aditelik/plane-controller/BOMs/Plane_Project_Digikey_BOM_V2.xlsx

Index | Part Number | Manufacturer Part Number | Description | Quantity | Unit Price | Extended Price
1 | RSF1JTR470CT-ND | RSF1JTR470 | RES 0.47 OHM 1W 5% AXIAL | 6 | 0.23 | 1.38
2 | YAG3757CT-ND | AC0805JR-07100RL | RES SMD 100 OHM 5% 1/8W 0805 | 10 | 0.041 | 0.41
3 | P200CCT-ND | ERJ-6ENF2000V | RES SMD 200 OHM 1% 1/8W 0805 | 3 | 0.1 | 0.30
4 | 486-3465-ND | 1301.9314 | SWITCH TACTILE SPST-NO 0.05A 12V | 3 | 0.24 | 0.72
5 | 277-1578-ND | 1935174 | TERM BLK 3POS SIDE ENTRY 5MM PCB | 2 | 0.6 | 1.20
6 | TC33X-103ECT-ND | TC33X-2-103E | TRIMMER 10K OHM 0.1W J LEAD TOP | 3 | 0.28 | 0.84
7 | 399-1161-1-ND | C0805C153K5RACTU | CAP CER 0.015UF 50V X7R 0805 | 3 | 0.1 | 0.30
8 | 732-7672-1-ND | 885012207078 | CAP CER 1UF 25V X7R 0805 | 20 | 0.08 | 1.60
9 | 516-2581-1-ND | HCPL-181-00DE | OPTOISO 3.75KV TRANS 4MINIFLAT | 2 | 0.58 | 1.16
10 | IRLB8721PBF-ND | IRLB8721PBF | MOSFET N-CH 30V 62A TO-220AB | 4 | 0.85 | 3.40
11 | 401-2002-1-ND | JS202011SCQN | SWITCH SLIDE DPDT 300MA 6V | 2 | 0.48 | 0.96
 |  |  |  |  | Total Price | 12.27
