aditelik/plane-controller/BOMs/Plane_Project_Kicad_BOM_V2.xlsx

Value | Description | Quantity Needed | Quantity Available | Min Order Quantity | Quantity Ordered
0.47 | Resistor, US symbol | 2 | 0 | 2 | 6
1 | Resistor, US symbol | 1 | 10 | 0
10 | Resistor, US symbol | 10 | 14 | 0
100 | Resistor, US symbol | 7 | 0 | 7 | 10
150 | Resistor, US symbol | 1 | 0 | 1 | 3
300 | Resistor, US symbol | 3 | 6 | 0
800 | Resistor, US symbol | 1 | 2 | 0
1301.9314 | Push button switch, four pins, small | 2 | 1 | 1 | 3
1935174 | 3 WAY SCREW TERMINAL BLOCK 5MM PITCH Phoenix Contact Non-Fused Terminal Block | 1 | 0 | 1 | 2
0.1uF | Unpolarized capacitor | 14 | 26 | 0
100K | Resistor, US symbol | 13 | 23 | 0
10K | Resistor, US symbol | 10 | 21 | 0
10K Pot | Trim-potentiometer, US symbol | 1 | 0 | 1 | 3
15nF | Unpolarized capacitor, small symbol | 1 | 0 | 1 | 3
1K | Resistor, US symbol | 5 | 19 | 0
1N5819 | 30V 1A Schottky Barrier Rectifier Diode, DO-41 | 3 | 13 | 0
1uF | Unpolarized capacitor | 17 | 6 | 11 | 20
22pF | Unpolarized capacitor, small symbol | 2 | 8 | 0
47uF | Polarized capacitor | 4 | 7 | 0
5A Fuse | Fuse | 1 | 2 | 0
9B-16.000MBBK-B | 16 MHz Crystal | 1 | 4 | 0
ATmega328P-PU | 20MHz, 32kB Flash, 2kB SRAM, 1kB EEPROM, DIP-28 | 1 | 2 | 0
BAT54HT1G | 100V 0.3A Small Signal Fast Switching Diode, DO-35 | 2 | 3 | 0
BL01RN1A1D2B | Ferrite bead | 1 | 2 | 0
D6C40 F1 LFS | Push button switch, four pins, green | 1 | 1 | 0
DMN65D8L-7 | 0.21A Id, 60V Vds, N-Channel MOSFET, SOT-23 | 2 | 3 | 0
HCPL-181-00DE | Optoisolator | 1 | 0 | 1 | 2
IRF4905 | -74A Id, -55V Vds, Single P-Channel HEXFET Power MOSFET, 20mOhm Ron, TO-220AB | 1 | 2 | 0
IRLB8721PBF | 62A Id, 30V Vds, N-Channel MOSFET, TO-220 | 6 | 3 | 3 | 4
IRS2004 Socket | Half-Bridge Driver, 200V, 290/600mA, PDIP-8/SOIC-8 | 3 | 5 | 0
LM339 Socket | Quad Differential Comparators, DIP-14/SOIC-14/SSOP-14 | 1 | 2 | 0
LM7805_TO220 | Positive 1A 35V Linear Regulator, Fixed Output 5V, TO-220 | 1 | 2 | 0
LTST-C171GKT | Light emitting diode, Green | 5 | 5 | 0
LTST-C171TBKT | Light emitting diode, Blue | 1 | 2 | 0
MCP601-xP Socket | Single 2.7V to 6.0V Single Supply CMOS Op Amps, DIP-8 | 1 | 1 | 0
SMF10A | Zener diode | 1 | 2 | 0
SMF12A | Zener diode | 1 | 1 | 0
SMF5.0A | Zener diode | 1 | 1 | 0
SW_Slide_DPDT | Slide Switch, dual pole double throw | 1 | 0 | 1 | 2
uA7810 | Positive 1A 35V Linear Regulator, Fixed Output 10V, TO-220/TO-263 | 1 | 1 | 0
