aditelik/plane-controller/BOMs/Plane_Project_Auto_BOM_V2.xlsx

Reference | Value | Description
C1 | 47uF | Polarized capacitor
C10 | 1uF | Unpolarized capacitor
C11 | 1uF | Unpolarized capacitor
C12 | 0.1uF | Unpolarized capacitor
C14 | 1uF | Unpolarized capacitor, small symbol
C15 | 22pF | Unpolarized capacitor, small symbol
C16 | 22pF | Unpolarized capacitor, small symbol
C17 | 0.1uF | Unpolarized capacitor
C18 | 0.1uF | Unpolarized capacitor
C19 | 47uF | Polarized capacitor
C2 | 47uF | Polarized capacitor
C20 | 1uF | Unpolarized capacitor
C21 | 0.1uF | Unpolarized capacitor
C22 | 1uF | Unpolarized capacitor, small symbol
C23 | 0.1uF | Unpolarized capacitor
C24 | 1uF | Unpolarized capacitor, small symbol
C25 | 0.1uF | Unpolarized capacitor, small symbol
C26 | 15nF | Unpolarized capacitor, small symbol
C27 | 0.1uF | Unpolarized capacitor
C28 | 0.1uF | Unpolarized capacitor
C29 | 0.1uF | Unpolarized capacitor
C3 | 1uF | Unpolarized capacitor
C30 | 1uF | Unpolarized capacitor
C31 | 1uF | Unpolarized capacitor
C32 | 1uF | Unpolarized capacitor
C36 | 0.1uF | Unpolarized capacitor, small symbol
C4 | 0.1uF | Unpolarized capacitor, small symbol
C5 | 0.1uF | Unpolarized capacitor
C6 | 0.1uF | Unpolarized capacitor
C7 | 47uF | Polarized capacitor
C8 | 0.1uF | Unpolarized capacitor
C9 | 1uF | Unpolarized capacitor
D1 | LTST-C171GKT | Light emitting diode, Green
D10 | LTST-C171TBKT | Light emitting diode, Blue
D12 | BAT54HT1G | 100V 0.3A Small Signal Fast Switching Diode, DO-35
D13 | BAT54HT1G | 100V 0.3A Small Signal Fast Switching Diode, DO-35
D14 | 1N5819 | 30V 1A Schottky Barrier Rectifier Diode, DO-41
D15 | 1N5819 | 30V 1A Schottky Barrier Rectifier Diode, DO-41
D16 | 1N5819 | 30V 1A Schottky Barrier Rectifier Diode, DO-41
D2 | SMF12A | Zener diode
D4 | LTST-C171GKT | Light emitting diode, Green
D5 | SMF10A | Zener diode
D6 | LTST-C171KRKT | Light emitting diode, Green
D7 | LTST-C171GKT | Light emitting diode, Green
D8 | SMF5.0A | Zener diode
D9 | LTST-C171GKT | Light emitting diode, Green
F1 | 5A Fuse | Fuse
FB1 | BL01RN1A1D2B | Ferrite bead
J4 | 1935174 | 3 WAY SCREW TERMINAL BLOCK 5MM PITCH Phoenix Contact Non-Fused Terminal Block
Q10 | IRLB8721PBF | 62A Id, 30V Vds, N-Channel MOSFET, TO-220
Q11 | IRLB8721PBF | 62A Id, 30V Vds, N-Channel MOSFET, TO-220
Q2 | DMN65D8L-7 | 0.21A Id, 60V Vds, N-Channel MOSFET, SOT-23
Q3 | DMN65D8L-7 | 0.21A Id, 60V Vds, N-Channel MOSFET, SOT-23
Q5 | IRF4905 | -74A Id, -55V Vds, Single P-Channel HEXFET Power MOSFET, 20mOhm Ron, TO-220AB
Q6 | IRLB8721PBF | 62A Id, 30V Vds, N-Channel MOSFET, TO-220
Q7 | IRLB8721PBF | 62A Id, 30V Vds, N-Channel MOSFET, TO-220
Q8 | IRLB8721PBF | 62A Id, 30V Vds, N-Channel MOSFET, TO-220
Q9 | IRLB8721PBF | 62A Id, 30V Vds, N-Channel MOSFET, TO-220
R1 | 1K | Resistor, US symbol
R10 | 10K | Resistor, US symbol
R12 | 100K | Resistor, US symbol
R13 | 10K | Resistor, US symbol
R14 | 150 | Resistor, US symbol
R16 | 1K | Resistor, US symbol
R17 | 1K | Resistor, US symbol
R19 | 100K | Resistor, US symbol
R20 | 100K | Resistor, US symbol
R21 | 1 | Resistor, US symbol
R22 | 100K | Resistor, US symbol
R23 | 0.47 | Resistor, US symbol
R24 | 1K | Resistor, US symbol
R25 | 0.47 | Resistor, US symbol
R26 | 10K | Resistor, US symbol
R27 | 10K | Resistor, US symbol
R28 | 10K | Resistor, US symbol
R29 | 10K | Resistor, US symbol
R3 | 1K | Resistor, US symbol
R30 | 10K | Resistor, US symbol
R31 | 10 | Resistor, US symbol
R32 | 10 | Resistor, US symbol
R33 | 10 | Resistor, US symbol
R34 | 10 | Resistor, US symbol
R35 | 10 | Resistor, US symbol
R36 | 10 | Resistor, US symbol
R37 | 10 | Resistor, US symbol
R38 | 10 | Resistor, US symbol
R39 | 10 | Resistor, US symbol
R4 | 300 | Resistor, US symbol
R40 | 100K | Resistor, US symbol
R41 | 100K | Resistor, US symbol
R42 | 100K | Resistor, US symbol
R43 | 100K | Resistor, US symbol
R44 | 100K | Resistor, US symbol
R45 | 100K | Resistor, US symbol
R46 | 100K | Resistor, US symbol
R47 | 100K | Resistor, US symbol
R48 | 100K | Resistor, US symbol
R49 | 10K | Resistor, US symbol
R5 | 800 | Resistor, US symbol
R50 | 10K | Resistor, US symbol
R51 | 10K | Resistor, US symbol
R52 | 100 | Resistor, US symbol
R6 | 300 | Resistor, US symbol
R7 | 300 | Resistor, US symbol
R8 | 10 | Resistor, US symbol
RV1 | 10K Pot | Trim-potentiometer, US symbol
SW2 | D6C40 F1 LFS | Push button switch, generic, two pins
SW3 | 1301.9314 | Push button switch, generic, two pins
SW4 | 1301.9314 | Push button switch, generic, two pins
SW5 | SW_Push_DPDT | Momentary Switch, dual pole double throw
U1 | ATmega328P-PU | 20MHz, 32kB Flash, 2kB SRAM, 1kB EEPROM, DIP-28
U2 | uA7810 | Positive 1A 35V Linear Regulator, Fixed Output 10V, TO-220/TO-263
U3 | LM7805_TO220 | Positive 1A 35V Linear Regulator, Fixed Output 5V, TO-220
U4 | MCP601-xP | Single 2.7V to 6.0V Single Supply CMOS Op Amps, DIP-8
U5 | LM339 | Quad Differential Comparators, DIP-14/SOIC-14/SSOP-14
U6 | IRS2004 | Half-Bridge Driver, 200V, 290/600mA, PDIP-8/SOIC-8
U7 | IRS2004 | Half-Bridge Driver, 200V, 290/600mA, PDIP-8/SOIC-8
U8 | IRS2004 | Half-Bridge Driver, 200V, 290/600mA, PDIP-8/SOIC-8
U9 | HCPL-181-00DE
Y1 | 9B-16.000MBBK-B | 16 MHz Crystal
