aditelik/plane-controller/KicadFiles/bldc_controller_v2.kicad_pcb

## KiCad design KicadFiles/bldc_controller_v2.kicad_pcb (2020-01-07)

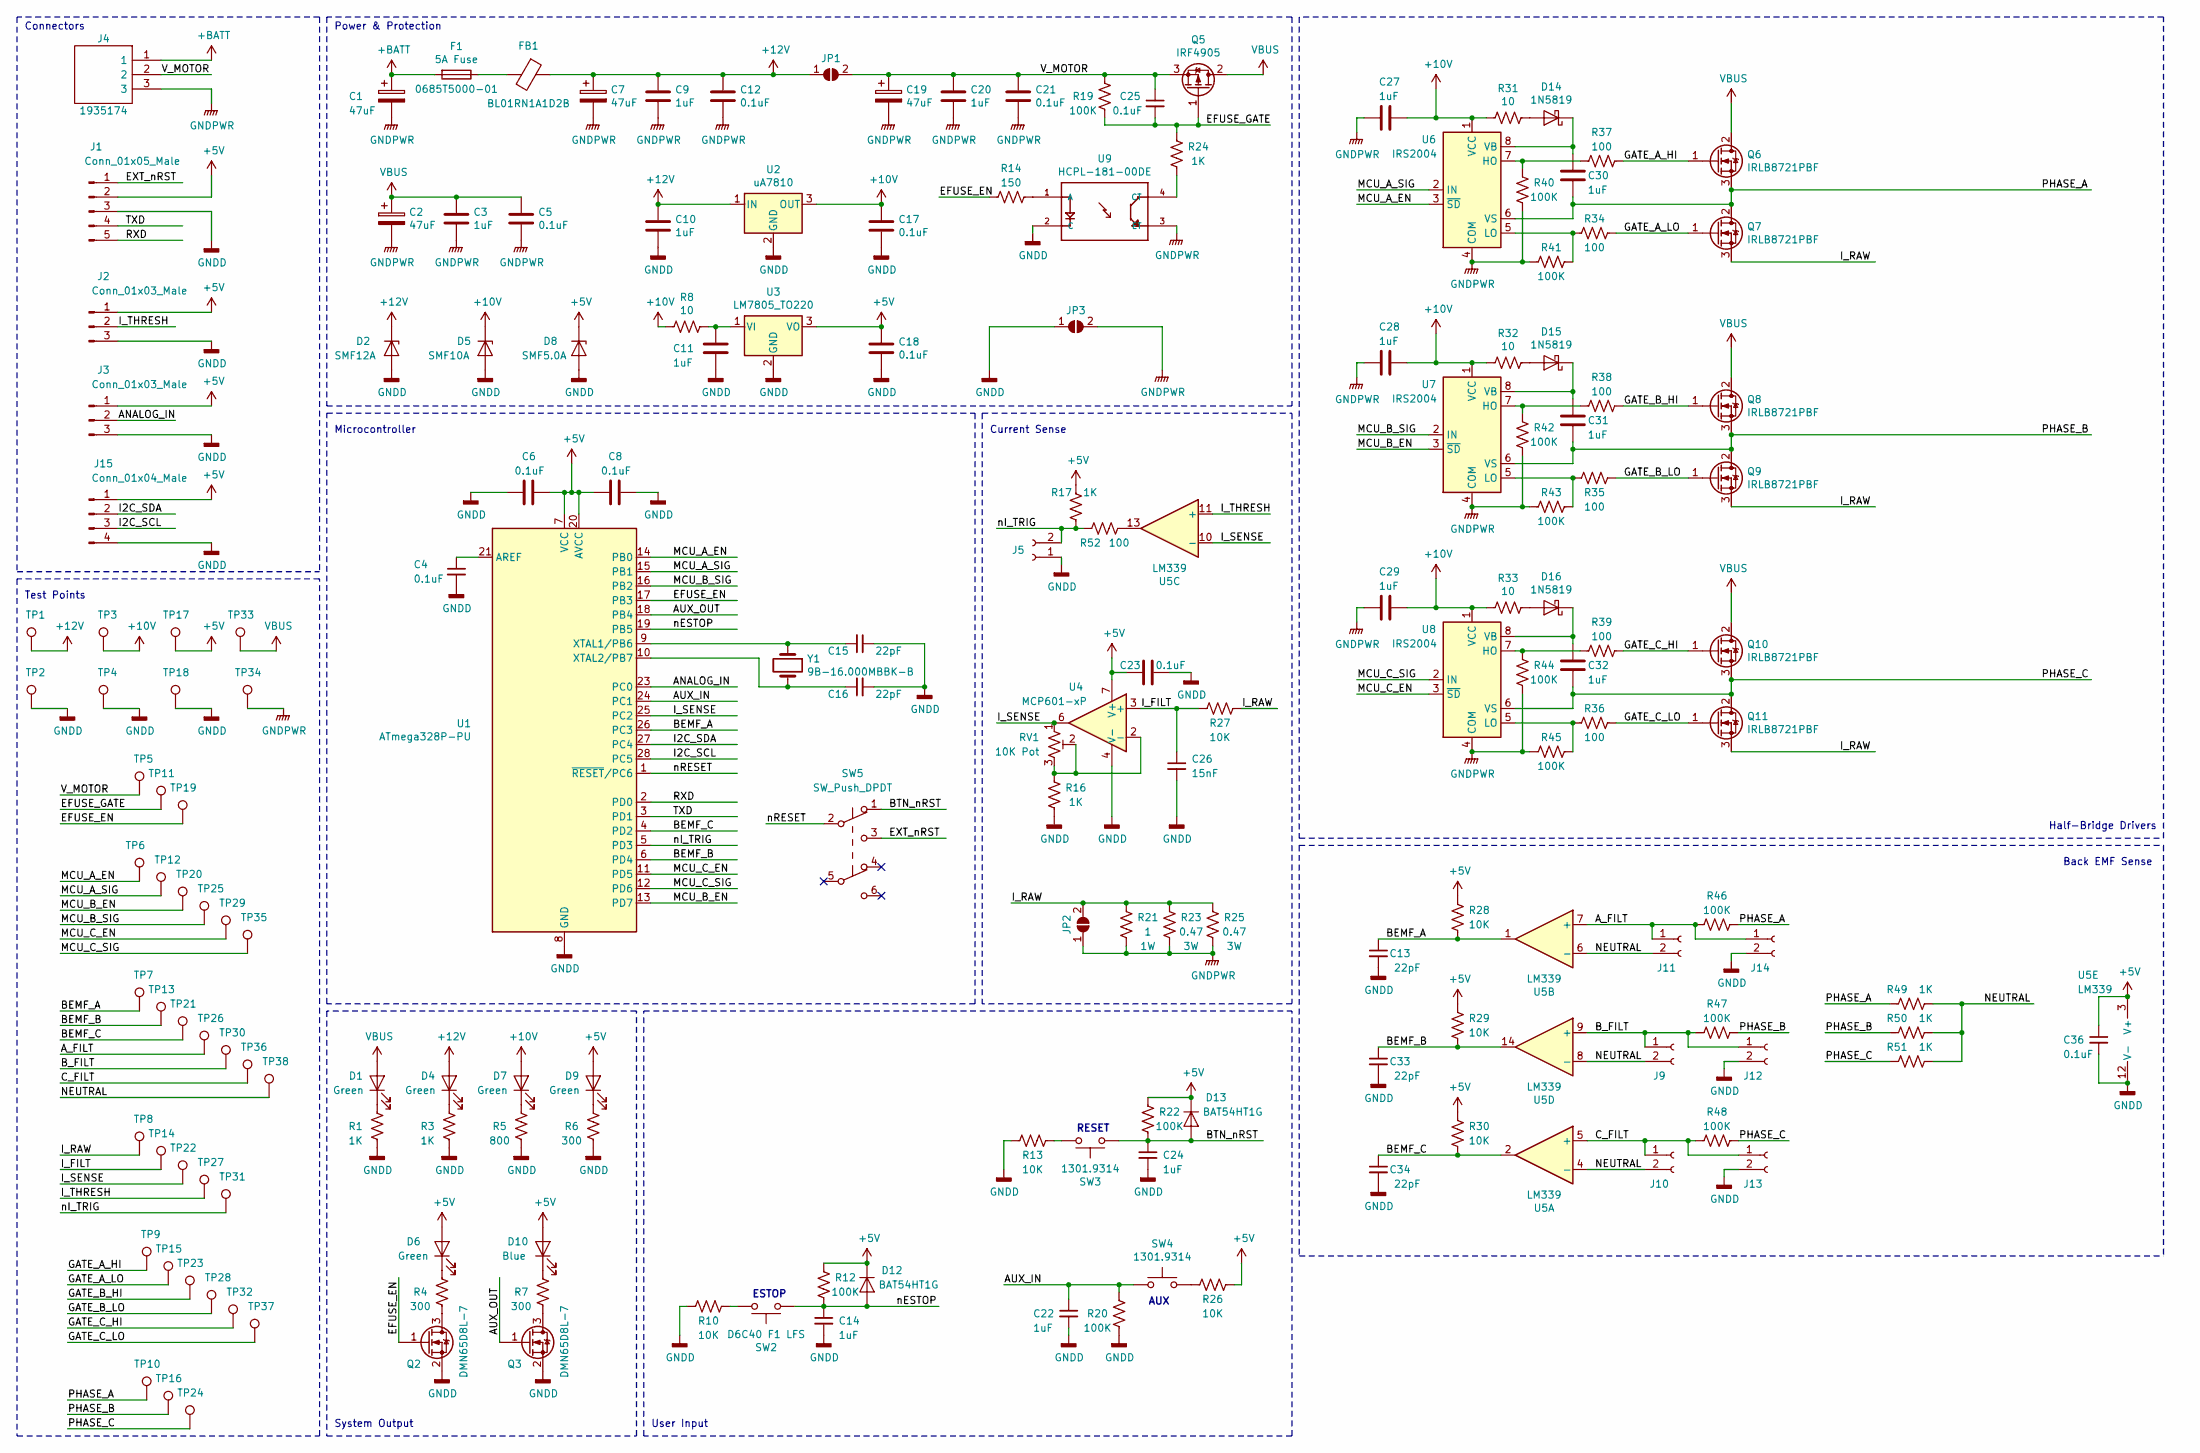
[picture p1: schematic bldc_controller_v2.sch, BLDC Motor Controller]

Parts:
C1, C2, C7, C19: 47uF; CP_Radial_D5.0mm_P2.00mm
C3, C9, C10, C11, C14, C20, C22, C24, C27, C28, C29, C30, C31, C32: 1uF; C_0805_2012Metric_Pad1.15x1.40mm_HandSolder
C4, C5, C6, C8, C12, C17, C18, C21, C23, C25, C36: 0.1uF; C_0805_2012Metric_Pad1.15x1.40mm_HandSolder
C13, C15, C16, C33, C34: 22pF; C_0805_2012Metric_Pad1.15x1.40mm_HandSolder
C26: 15nF; C_0805_2012Metric_Pad1.15x1.40mm_HandSolder
D1, D4, D7, D9: LTST-C171GKT; LED_0805_2012Metric_Pad1.15x1.40mm_HandSolder
D2: SMF12A; D_SOD-123F
D5: SMF10A; D_SOD-123F
D6: LTST-C171KRKT; LED_0805_2012Metric_Pad1.15x1.40mm_HandSolder
D8: SMF5.0A; D_SOD-123F
D10: LTST-C171TBKT; LED_0805_2012Metric_Pad1.15x1.40mm_HandSolder
D12, D13: BAT54HT1G; D_SOD-323_HandSoldering
D14, D15, D16: 1N5819; D_SOD-123
F1: 5A Fuse; Fuse_1206_3216Metric_Pad1.42x1.75mm_HandSolder; Part Number 0685T5000-01
FB1: BL01RN1A1D2B; Ferrite_Bead_TH
J1: Conn_01x05_Male; PinHeader_1x05_P2.54mm_Vertical
J2, J3: Conn_01x03_Male; PinHeader_1x03_P2.54mm_Vertical
J4: 1935174; SHDR3W110P0X500_1X3_1500X900X1140P; Mouser Part Number 651-1935174
J5, J9, J10, J11, J12, J13, J14: Conn_01x02_Female; PinSocket_1x02_P2.54mm_Vertical
J15: Conn_01x04_Male; PinHeader_1x04_P2.54mm_Vertical
JP1, JP2, JP3: SolderJumper_2_Open; Solder_Jumper_2_Pin_5A
Q2, Q3: DMN65D8L-7; SOT-23
Q5: IRF4905; TO-220-3_Vertical
Q6, Q7, Q8, Q9, Q10, Q11: IRLB8721PBF; TO-220-3_Vertical
R1, R3, R16, R17, R24, R49, R50, R51: 1K; R_0805_2012Metric_Pad1.15x1.40mm_HandSolder
R4, R6, R7: 300; R_0805_2012Metric_Pad1.15x1.40mm_HandSolder
R5: 800; R_0805_2012Metric_Pad1.15x1.40mm_HandSolder
R8, R31, R32, R33: 10; R_0805_2012Metric_Pad1.15x1.40mm_HandSolder
R10, R13, R26, R27, R28, R29, R30: 10K; R_0805_2012Metric_Pad1.15x1.40mm_HandSolder
R12, R19, R20, R22, R40, R41, R42, R43, R44, R45, R46, R47, R48: 100K; R_0805_2012Metric_Pad1.15x1.40mm_HandSolder
R14: 150; R_0805_2012Metric_Pad1.15x1.40mm_HandSolder
R21: 1; Power_Resistor_TH
R23, R25: 0.47; Power_Resistor_TH
R34, R35, R36, R37, R38, R39, R52: 100; R_0805_2012Metric_Pad1.15x1.40mm_HandSolder
RV1: 10K Pot; Trimmer_Pot_SM
SW2: D6C40 F1 LFS; Pushbutton_Switch_TH
SW3, SW4: 1301.9314; Tactile_Switch_SM
SW5: SW_Push_DPDT; Slide_Switch_DPDT_SMD
TP1, TP3, TP5, TP6, TP7, TP8, TP9, TP10, TP11, TP12, TP13, TP14, TP15, TP16, TP17, TP19, TP20, TP21, TP22, TP23, TP24, TP25, TP26, TP27, TP28, TP29, TP30, TP31, TP32, TP33, TP35, TP36, TP37, TP38: TestPoint; TestPoint_THTPad_1.0x1.0mm_Drill0.5mm
TP2, TP4, TP18, TP34: TestPoint; TestPoint_Keystone_5000-5004_Miniature
U1: ATmega328P-PU; DIP-28_W7.62mm
U2: uA7810; TO-220-3_Vertical
U3: LM7805_TO220; TO-220-3_Vertical
U4: MCP601-xP; DIP-8_W7.62mm
U5: LM339; DIP-14_W7.62mm
U6, U7, U8: IRS2004; DIP-8_W7.62mm
U9: HCPL-181-00DE; SOIC254P700X220-4N
Y1: 9B-16.000MBBK-B; Crystal_16MHz_TH

Connections:
+5V: C6.2, C8.1, C18.1, C23.1, C36.1, D6.2 (A), D8.1 (K), D9.2 (A), D10.2 (A), D12.1 (K), D13.1 (K), J1.2, J2.1, J3.1, J15.1, R12.1, R17.1, R22.1, R26.1, R28.1, R29.1, R30.1, TP17.1, U1.7 (VCC), U1.20 (AVCC), U3.3 (VO), U4.7 (V+), U5.3 (V+)
+10V: C17.1, C27.2, C28.2, C29.2, D5.1 (K), D7.2 (A), R8.2, R31.2, R32.2, R33.2, TP3.1, U2.3 (OUT), U6.1 (VCC), U7.1 (VCC), U8.1 (VCC)
+12V: C7.1, C9.1, C10.1, C12.1, D2.1 (K), D4.2 (A), FB1.1, JP1.1 (A), TP1.1, U2.1 (IN)
+BATT: C1.1, F1.2, J4.1
/ANALOG_IN: J3.2, U1.23 (PC0)
/AUX_IN: C22.1, R20.1, SW4.1, U1.24 (PC1)
/AUX_OUT: Q3.1 (G), U1.18 (PB4)
/A_FILT: J11.1, J14.1, R46.2, TP26.1, U5.7 (+)
/BEMF_A: C13.1, R28.2, TP7.1, U1.26 (PC3), U5.1
/BEMF_B: C33.1, R29.2, TP13.1, U1.6 (PD4), U5.14
/BEMF_C: C34.1, R30.2, TP21.1, U1.4 (PD2), U5.2
/BTN_nRST: C24.1, D13.2 (A), R22.2, SW3.1, SW5.1 (A)
/B_FILT: J9.1, J12.1, R47.2, TP30.1, U5.9 (+)
/C_FILT: J10.1, J13.1, R48.2, TP36.1, U5.5 (+)
/EFUSE_EN: Q2.1 (G), R14.2, TP19.1, U1.17 (PB3)
/EFUSE_GATE: C25.2, Q5.1 (G), R19.2, R24.1, TP11.1
/EXT_nRST: J1.1, SW5.3 (C)
/GATE_A_HI: Q6.1 (G), R37.1, TP9.1
/GATE_A_LO: Q7.1 (G), R34.1, TP15.1
/GATE_B_HI: Q8.1 (G), R38.1, TP23.1
/GATE_B_LO: Q9.1 (G), R35.1, TP28.1
/GATE_C_HI: Q10.1 (G), R39.1, TP32.1
/GATE_C_LO: Q11.1 (G), R36.1, TP37.1
/I2C_SCL: J15.3, U1.28 (PC5)
/I2C_SDA: J15.2, U1.27 (PC4)
/I_FILT: C26.1, R27.2, TP14.1, U4.3 (+)
/I_RAW: JP2.2 (B), Q7.3 (S), Q9.3 (S), Q11.3 (S), R21.1, R23.1, R25.1, R27.1, TP8.1
/I_SENSE: RV1.1, TP22.1, U1.25 (PC2), U4.6, U5.10 (-)
/I_THRESH: J2.2, TP27.1, U5.11 (+)
/MCU_A_EN: TP6.1, U1.14 (PB0), U6.3 (~SD)
/MCU_A_SIG: TP12.1, U1.15 (PB1), U6.2 (IN)
/MCU_B_EN: TP20.1, U1.13 (PD7), U7.3 (~SD)
/MCU_B_SIG: TP25.1, U1.16 (PB2), U7.2 (IN)
/MCU_C_EN: TP29.1, U1.11 (PD5), U8.3 (~SD)
/MCU_C_SIG: TP35.1, U1.12 (PD6), U8.2 (IN)
/NEUTRAL: J9.2, J10.2, J11.2, R49.1, R50.1, R51.1, TP38.1, U5.4 (-), U5.6 (-), U5.8 (-)
/PHASE_A: C30.2, Q6.3 (S), Q7.2 (D), R46.1, R49.2, TP10.1, U6.6 (VS)
/PHASE_B: C31.2, Q8.3 (S), Q9.2 (D), R47.1, R50.2, TP16.1, U7.6 (VS)
/PHASE_C: C32.2, Q10.3 (S), Q11.2 (D), R48.1, R51.2, TP24.1, U8.6 (VS)
/RXD: J1.5, U1.2 (PD0)
/TXD: J1.4, U1.3 (PD1)
/V_MOTOR: C19.1, C20.1, C21.1, C25.1, J4.2, JP1.2 (B), Q5.3 (S), R19.1, TP5.1
/nESTOP: C14.1, D12.2 (A), R12.2, SW2.1, U1.19 (PB5)
/nI_TRIG: J5.2, R17.2, R52.2, TP31.1, U1.5 (PD3)
/nRESET: SW5.2 (B), U1.1 (~RESET~/PC6)
GNDD: C4.2, C6.1, C8.2, C10.2, C11.2, C13.2, C14.2, C15.1, C16.2, C17.2, C18.2, C22.2, C23.2, C24.2, C26.2, C33.2, C34.2, C36.2, D2.2 (A), D5.2 (A), D8.2 (A), J1.3, J2.3, J3.3, J5.1, J12.2, J13.2, J14.2, J15.4, JP3.1 (A), Q2.2 (S), Q3.2 (S), R1.2, R3.2, R5.2, R6.2, R10.2, R13.2, R16.2, R20.2, TP2.1, TP4.1, TP18.1, U1.8 (GND), U1.22 (GND), U2.2 (GND), U3.2 (GND), U4.4 (V-), U5.12 (V-), U9.2 (C)
GNDPWR: C1.2, C2.2, C3.2, C5.2, C7.2, C9.2, C12.2, C19.2, C20.2, C21.2, C27.1, C28.1, C29.1, J4.3, JP2.1 (A), JP3.2 (B), R21.2, R23.2, R25.2, R40.2, R41.2, R42.2, R43.1, R44.1, R45.2, TP34.1, U6.4 (COM), U7.4 (COM), U8.4 (COM), U9.3 (ET)
unnamed: C4.1, U1.21 (AREF)
unnamed: C11.1, R8.1, U3.1 (VI)
unnamed: C15.2, U1.9 (XTAL1/PB6), Y1.1
unnamed: C16.1, U1.10 (XTAL2/PB7), Y1.2
unnamed: C30.1, D14.1 (K), U6.8 (VB)
unnamed: C31.1, D15.1 (K), U7.8 (VB)
unnamed: C32.1, D16.1 (K), U8.8 (VB)
unnamed: D1.1 (K), R1.1
unnamed: D4.1 (K), R3.1
unnamed: D6.1 (K), R4.1
unnamed: D7.1 (K), R5.1
unnamed: D9.1 (K), R6.1
unnamed: D10.1 (K), R7.1
unnamed: D14.2 (A), R31.1
unnamed: D15.2 (A), R32.1
unnamed: D16.2 (A), R33.1
unnamed: F1.1, FB1.2
unnamed: Q2.3 (D), R4.2
unnamed: Q3.3 (D), R7.2
unnamed: R10.1, SW2.2
unnamed: R13.1, SW3.2
unnamed: R14.1, U9.1 (A)
unnamed: R16.1, RV1.2, RV1.3, U4.2 (-)
unnamed: R24.2, U9.4 (CT)
unnamed: R26.2, SW4.2
unnamed: R34.2, R41.1, U6.5 (LO)
unnamed: R35.2, R43.2, U7.5 (LO)
unnamed: R36.2, R45.1, U8.5 (LO)
unnamed: R37.2, R40.1, U6.7 (HO)
unnamed: R38.2, R42.1, U7.7 (HO)
unnamed: R39.2, R44.2, U8.7 (HO)
unnamed: R52.1, U5.13
VBUS: C2.1, C3.1, C5.1, D1.2 (A), Q5.2 (D), Q6.2 (D), Q8.2 (D), Q10.2 (D), TP33.1

Notes on the sheet:
Power & Protection
Half-Bridge Drivers
Back EMF Sense
Microcontroller
ESTOP
User Input
AUX
RESET
System Output
Current Sense
Test Points
Connectors

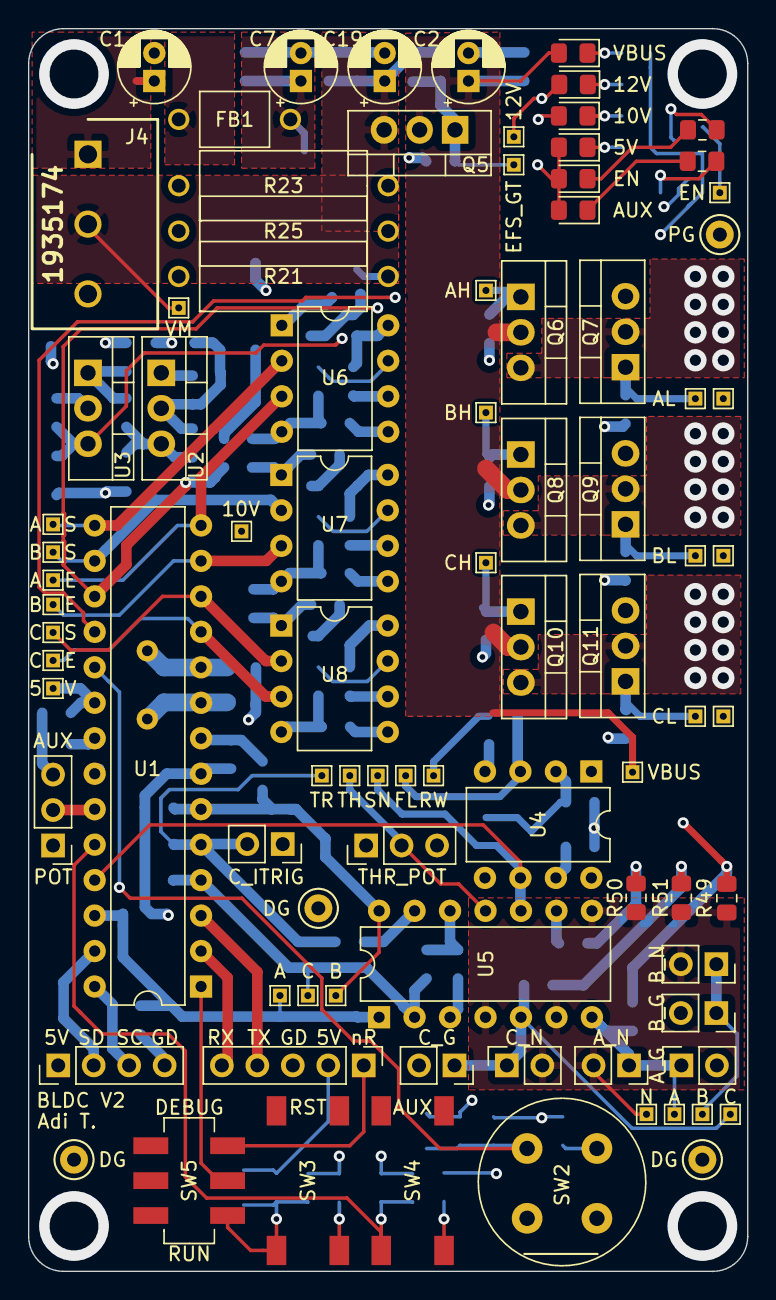
[picture p2: board bldc_controller_v2.kicad_pcb from above]

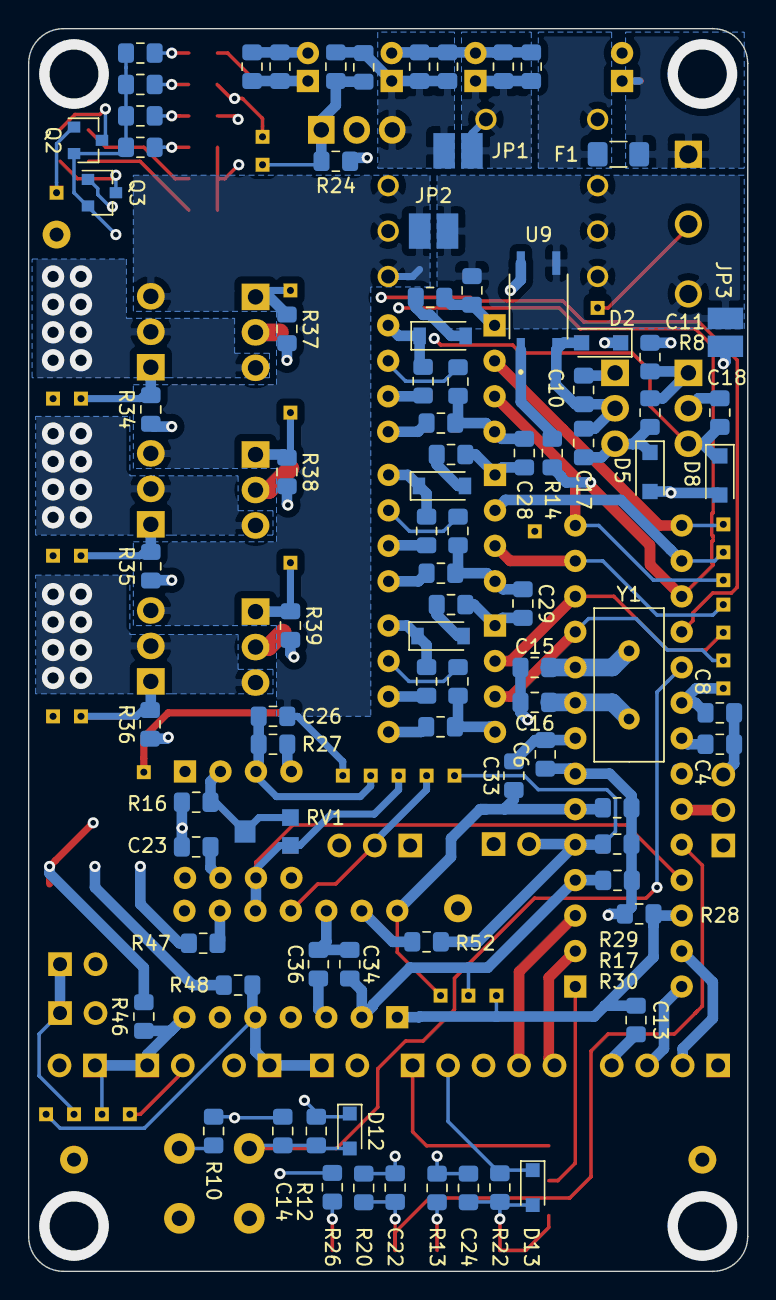
[picture p3: board bldc_controller_v2.kicad_pcb from below]

Board: 4 copper layers, 51.5 x 89.0 mm, 175 parts (87 on the bottom side), 80 nets.
