aditelik/plane-controller/(commit log)

2019-12-18 Add BOM and KiCad Files
    [Plane_Project_Digikey_BOM_V1.xlsx, bldc_controller_v2.kicad_pcb, bldc_controller_v2.sch]
2019-12-24 Ready for new Digikey BOM
    [Plane_Project_Digikey_BOM_V1.xlsx, bldc_controller_v2.sch]
2019-12-24 Updated Some Passives
    [bldc_controller_v2.sch]
2019-12-24 Removed DPDT Switch
    [bldc_controller_v2.sch]
2019-12-24 Reannotated Schematic and Filtered BEMF
    [bldc_controller_v2.sch]
2019-12-26 Reannotated and Cleaned Up Schematic
    [bldc_controller_v2.sch]
2019-12-27 Ready For Footprints
    [bldc_controller_v2.sch]
2019-12-27 Ready for Parts Placement
    [bldc_controller_v1.kicad_pcb, bldc_controller_v2.kicad_pcb, bldc_controller_v2.sch]
2019-12-27 Began Placement
    [bldc_controller_v2.kicad_pcb]
2019-12-27 Finished Placing Major Components
    [bldc_controller_v2.kicad_pcb]
2019-12-27 Cleaned Up Repo
    [bldc_controller_v2.sch]
2019-12-28 Added Optoisolator
    [bldc_controller_v2.kicad_pcb, bldc_controller_v2.sch]
2019-12-28 Updated Major Parts Placement
    [bldc_controller_v2.kicad_pcb, bldc_controller_v2.sch]
2019-12-28 Replaced FB with Jumper
    [bldc_controller_v2.kicad_pcb, bldc_controller_v2.sch]
2019-12-28 Updated 5V Regulator
    [bldc_controller_v2.kicad_pcb, bldc_controller_v2.sch]
2019-12-29 Updated FET Placement
    [bldc_controller_v2.kicad_pcb, bldc_controller_v2.sch]
2019-12-30 Need to Update MCU Signals
    [bldc_controller_v2.kicad_pcb]
2019-12-30 Ready to Route
    [bldc_controller_v2.kicad_pcb, bldc_controller_v2.sch]
2019-12-30 Began Routing
    [bldc_controller_v2.kicad_pcb]
2019-12-30 Finished Planes
    [bldc_controller_v2.kicad_pcb, bldc_controller_v2.sch]
2019-12-30 Finished First Pass of Routing
    [bldc_controller_v2.kicad_pcb, bldc_controller_v2.sch]
2019-12-30 Connected Test Points
    [bldc_controller_v2.kicad_pcb, bldc_controller_v2.sch]
2019-12-30 Fixed Unconnected Nets
    [bldc_controller_v2.kicad_pcb]
2019-12-31 Started Fixing Top Silk
    [bldc_controller_v2.kicad_pcb]
2019-12-31 Finished Top Silk
    [bldc_controller_v2.kicad_pcb]
2019-12-31 Compated Power Section
    [bldc_controller_v2.kicad_pcb, bldc_controller_v2.sch]
2019-12-31 Fixed Gate Test Points
    [bldc_controller_v2.kicad_pcb]
2019-12-31 Ready for DRC
    [bldc_controller_v2.kicad_pcb]
2019-12-31 Almost Passes DRC
    [bldc_controller_v2.kicad_pcb]
2019-12-31 Generated Gerbers
    [bldc_controller_v2-B_Cu.gbl, bldc_controller_v2-B_Mask.gbs, bldc_controller_v2-B_SilkS.gbo, bldc_controller_v2-Edge_Cuts.gm1, bldc_controller_v2-F_Cu.gtl, bldc_controller_v2-F_Mask.gts, bldc_controller_v2-F_SilkS.gto, bldc_controller_v2.drl]
2020-01-01 Added Potentiometer and Fixed Bottom Planes
    [bldc_controller_v2-B_Cu.gbl, bldc_controller_v2-B_Mask.gbs, bldc_controller_v2-B_SilkS.gbo, bldc_controller_v2-Edge_Cuts.gm1, bldc_controller_v2-F_Cu.gtl, bldc_controller_v2-F_Mask.gts, bldc_controller_v2-F_SilkS.gto, bldc_controller_v2.drl]
2020-01-03 Finished Kicad BOM V2
    [Plane_Project_Auto_BOM_V2.xlsx, Plane_Project_Digikey_BOM_V1.xlsx, Plane_Project_Kicad_BOM_V2.xlsx, bldc_controller_v2.kicad_pcb, bldc_controller_v2.sch]
2020-01-03 Added Digikey BOM V2
    [Plane_Project_Digikey_BOM_V2.xlsx, Plane_Project_Kicad_BOM_V2.xlsx]
2020-01-03 Added Caps to BEMF Lines
    [bldc_controller_v2-B_Cu.gbl, bldc_controller_v2-B_Mask.gbs, bldc_controller_v2-B_SilkS.gbo, bldc_controller_v2-Edge_Cuts.gm1, bldc_controller_v2-F_Cu.gtl, bldc_controller_v2-F_Mask.gts, bldc_controller_v2-F_SilkS.gto, bldc_controller_v2.drl]
2020-01-03 Fixed Charge Pumps and Added Text
    [Plane_Project_Digikey_BOM_V2.xlsx, Plane_Project_Kicad_BOM_V2.xlsx, bldc_controller_v2.kicad_pcb, bldc_controller_v2.sch]
2020-01-07 Updated Power Ground
    [bldc_controller_v2.kicad_pcb, bldc_controller_v2.sch]
